keelo12345/ker-exoskeleton-replica/cad/BASE-A(Rev).STEP

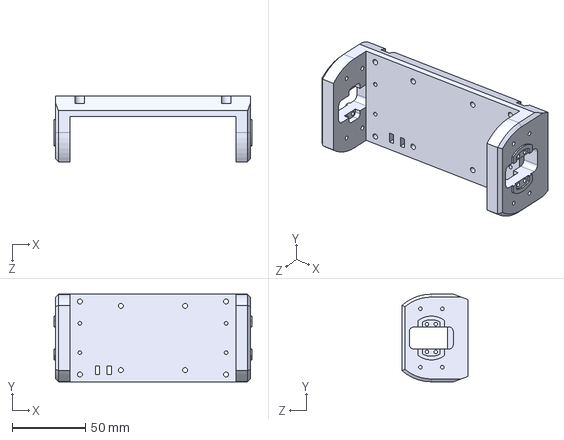
[picture p2: CAD file, 2026-10-13]
cad/BASE-A(Rev).STEP
135.5 x 60.0 x 45.0 mm
