keelo12345/ker-exoskeleton-replica/cad/Niceyrig_S483_KER_OSH_01(Rev).STEP

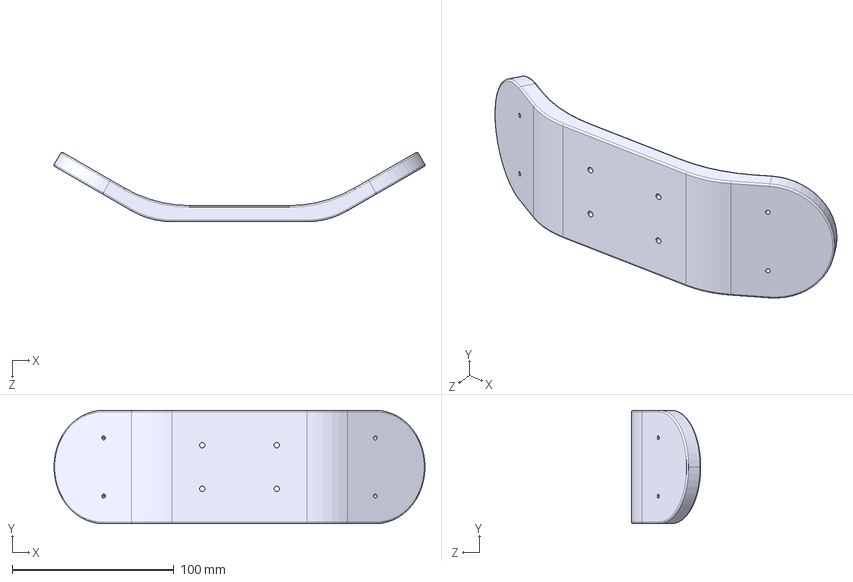
[picture p3: CAD file, 2026-10-13]
cad/Niceyrig_S483_KER_OSH_01(Rev).STEP
229.3 x 70.0 x 42.9 mm
