keelo12345/ker-exoskeleton-replica/cad/GRIP_HOLDER(Rev).STEP

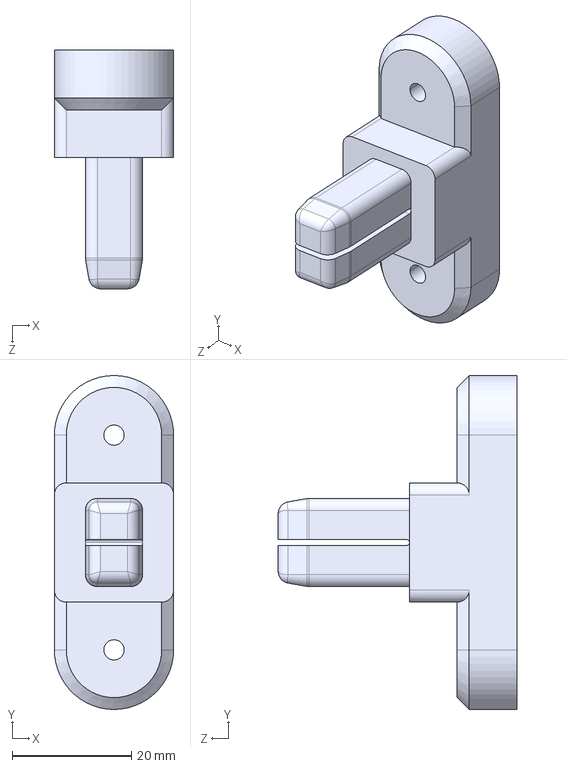
[picture p4: CAD file, 2026-10-13]
cad/GRIP_HOLDER(Rev).STEP
20.0 x 56.0 x 40.0 mm
