keelo12345/ker-exoskeleton-replica/cad/CHEST_MOUNT_a(Rev).STEP

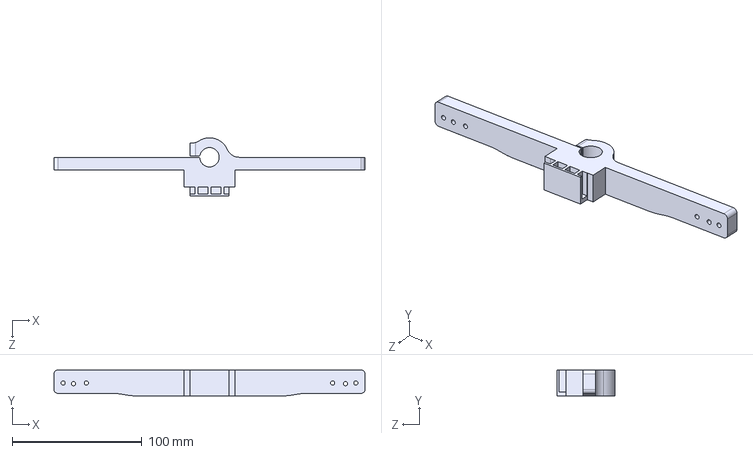
[picture p5: CAD file, 2026-10-13]
cad/CHEST_MOUNT_a(Rev).STEP
240.0 x 20.0 x 45.0 mm
